frontsidekante/balanceboard-arduino-footmouse/pictures/balanceboard_in_action.png

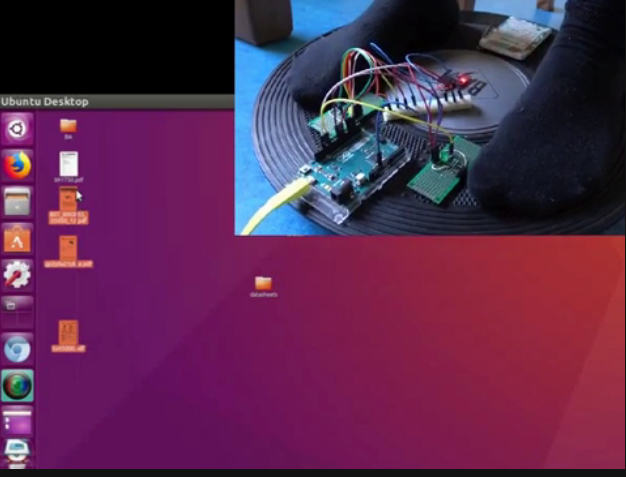
pictures/balanceboard_in_action.png
