frontsidekante/balanceboard-arduino-footmouse/pictures/BreakoutV1.png

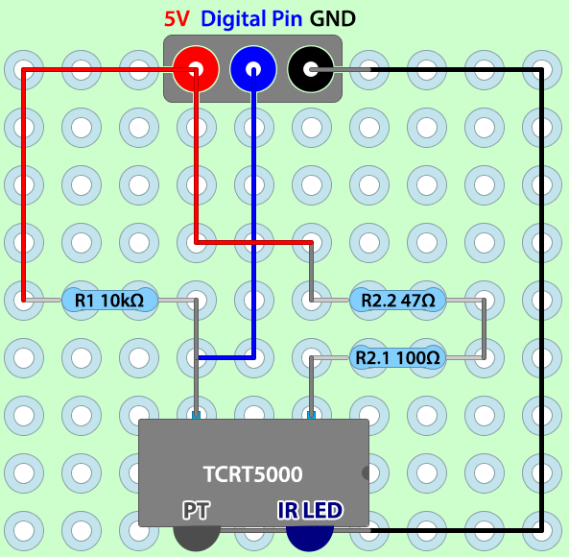
pictures/BreakoutV1.png
