frontsidekante/balanceboard-arduino-footmouse/f_handleRightFoot.ino

//implements open context menu and select / drag and drop

void handleRightFoot(){ 
  //select / drag and drop
  if(rightState == LOW && lastRightState == LOW && selectOn){
    Mouse.press();
    Mouse.move(-gyroX/widthSensitivity, gyroY/heightSensitivity);    
  }else{
      Mouse.release();
      //feet were down, are up now 
      if(rightState == HIGH && lastRightState== LOW){
        startTime = millis();  
      }
      //feet were up, are down now 
      else if(rightState == LOW && lastRightState == HIGH){
        unsigned long endTime = millis();
        unsigned long duration = endTime - startTime;
        if(duration < longClick){
          //open context menu
          Mouse.click(MOUSE_RIGHT);
        }
        else{
          //activate/deactivate select mode
          if(!selectOn){
            selectOn = true;
          }     
          else{
            selectOn = false;
          }
        }
      }
    }
  //update lastRightState
  lastRightState = rightState; 
}
  
  

  
