frontsidekante/balanceboard-arduino-footmouse/(commit log)

2018-03-04 redesigned -opencontextmenu-, added scroll dummy
    [Balanceboard.ino]
2018-03-05 redesigned double click, dumped scroll, implemented select/dragndrop
    [Balanceboard.ino]
2018-04-08 added i2cdev and mpu6050 library
